Igor-lc/GDi_Tracker/V3.1.pdf

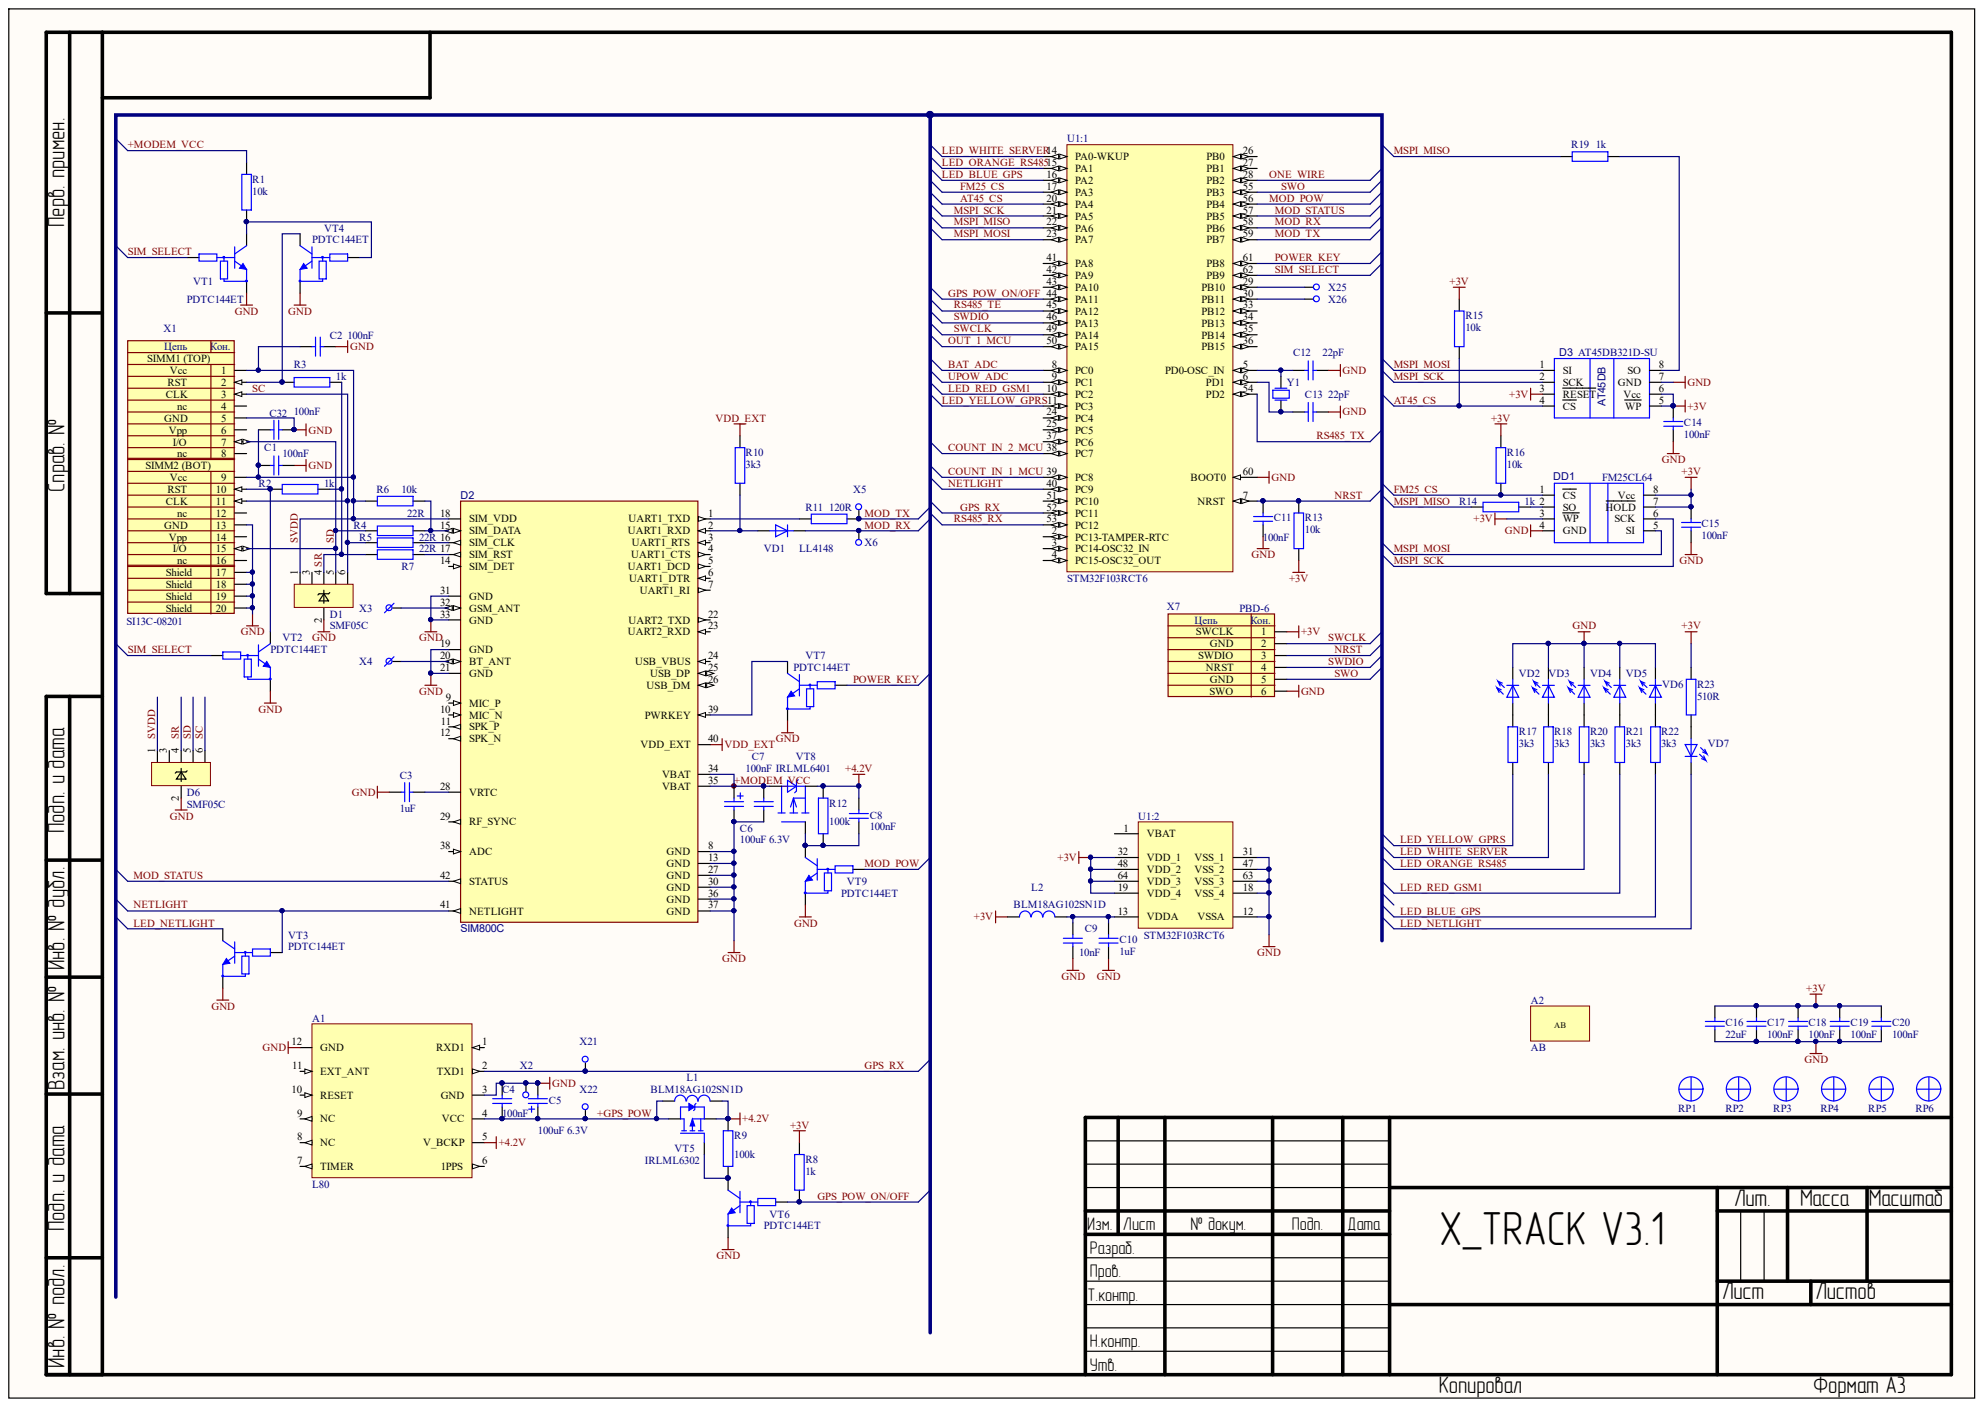
[picture p4: page 1]

Инв. № подл. Инв. № дубл. Подп. и дата Взам. инв. № Подп. и дата Перв. примен. Справ. №

V p p
I / O

Лит . | Масса | Масш таб

Изм . | Л и с т | № д о к у м . | По д п . | Д ата
Разр а б .
Пр о в .
Т . к о нтр . | | | | | Лист | Листов

Н . к о нтр .
Утв .

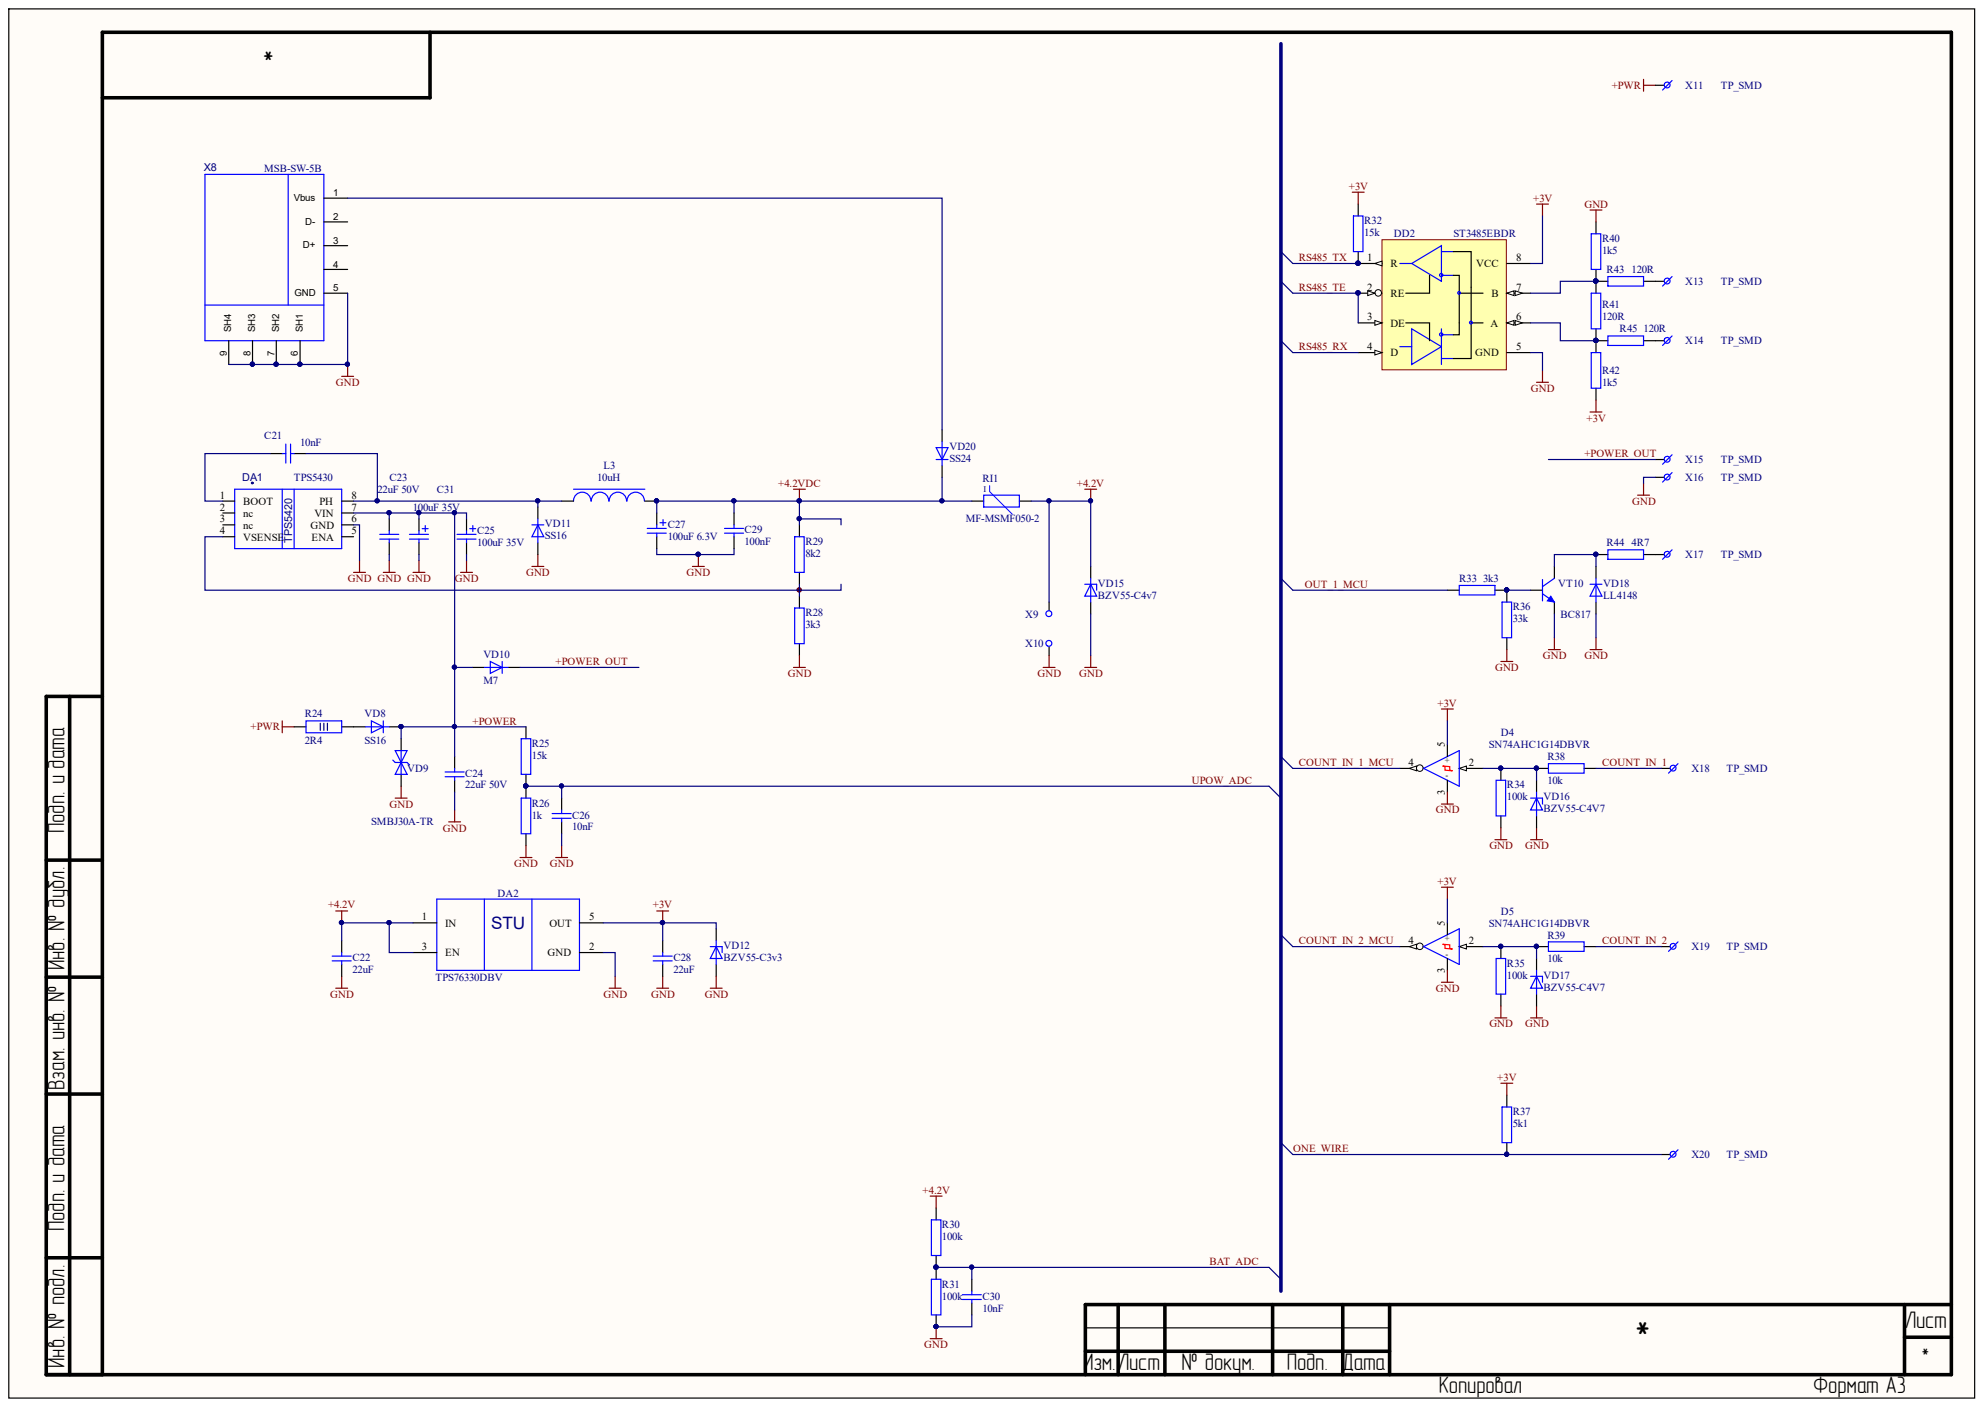
[picture p5: page 2]

* нв. № подл. Инв. № дубл. Подп. и дата Взам. инв. № Подп. и дата

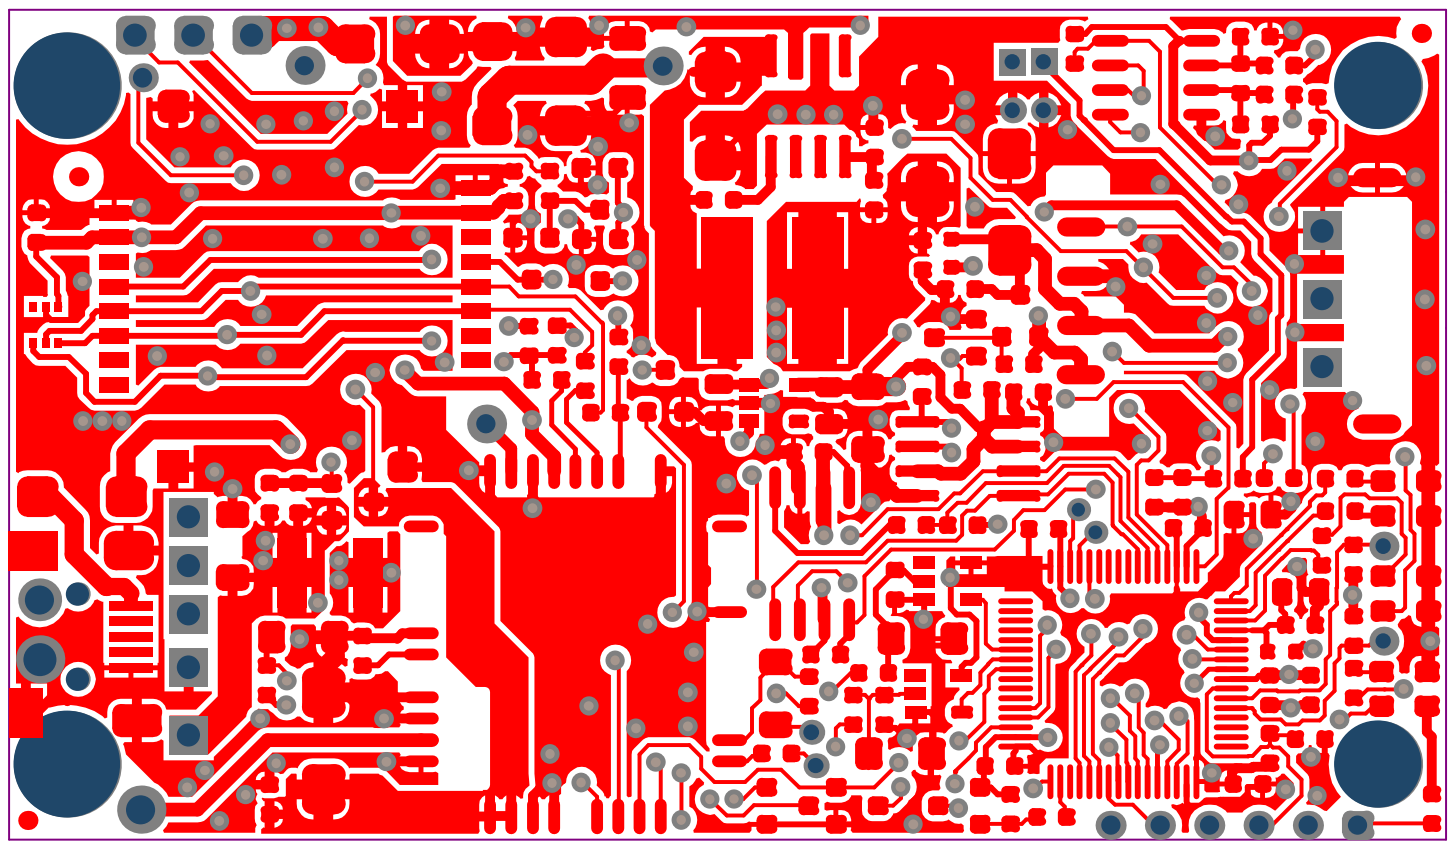
[picture p6: page 3]

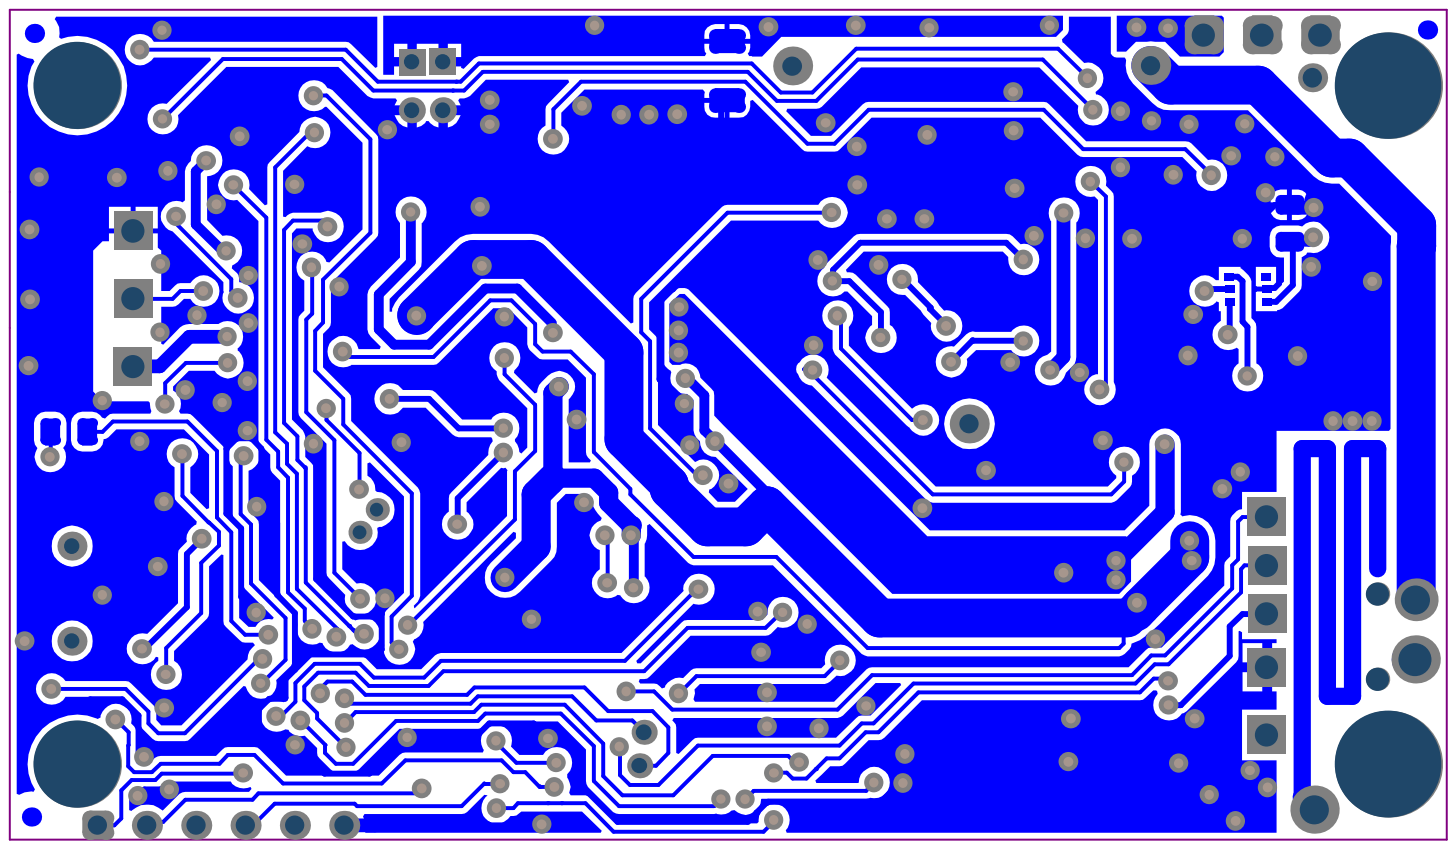
[picture p7: page 4]

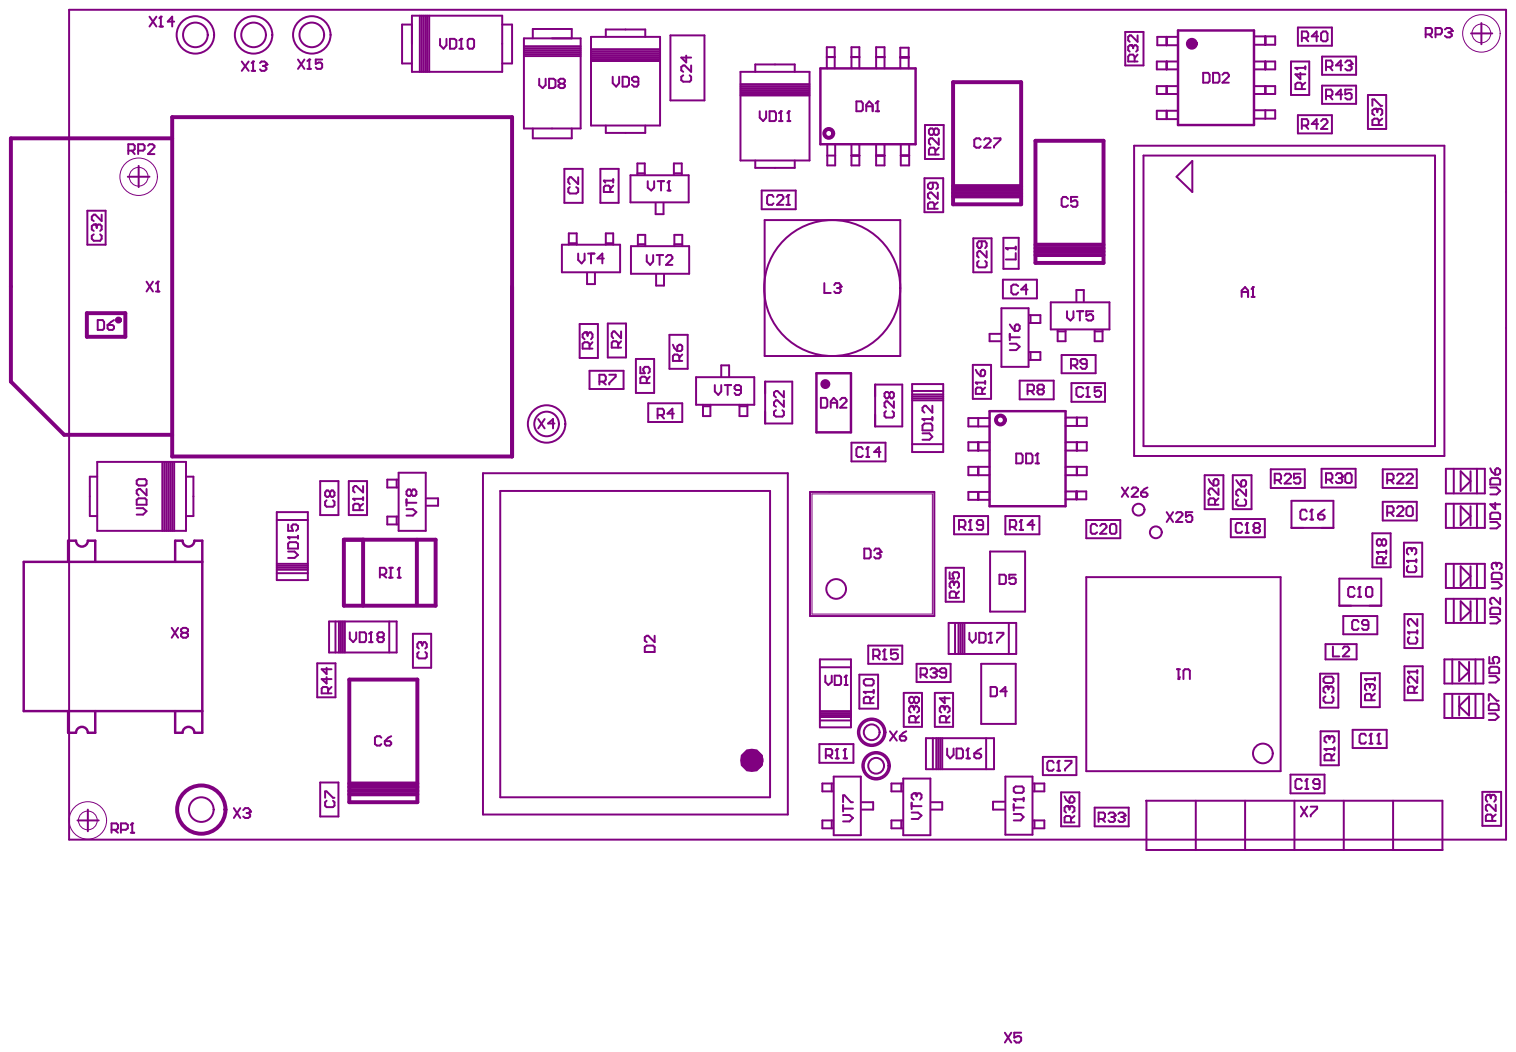
[picture p8: page 5]

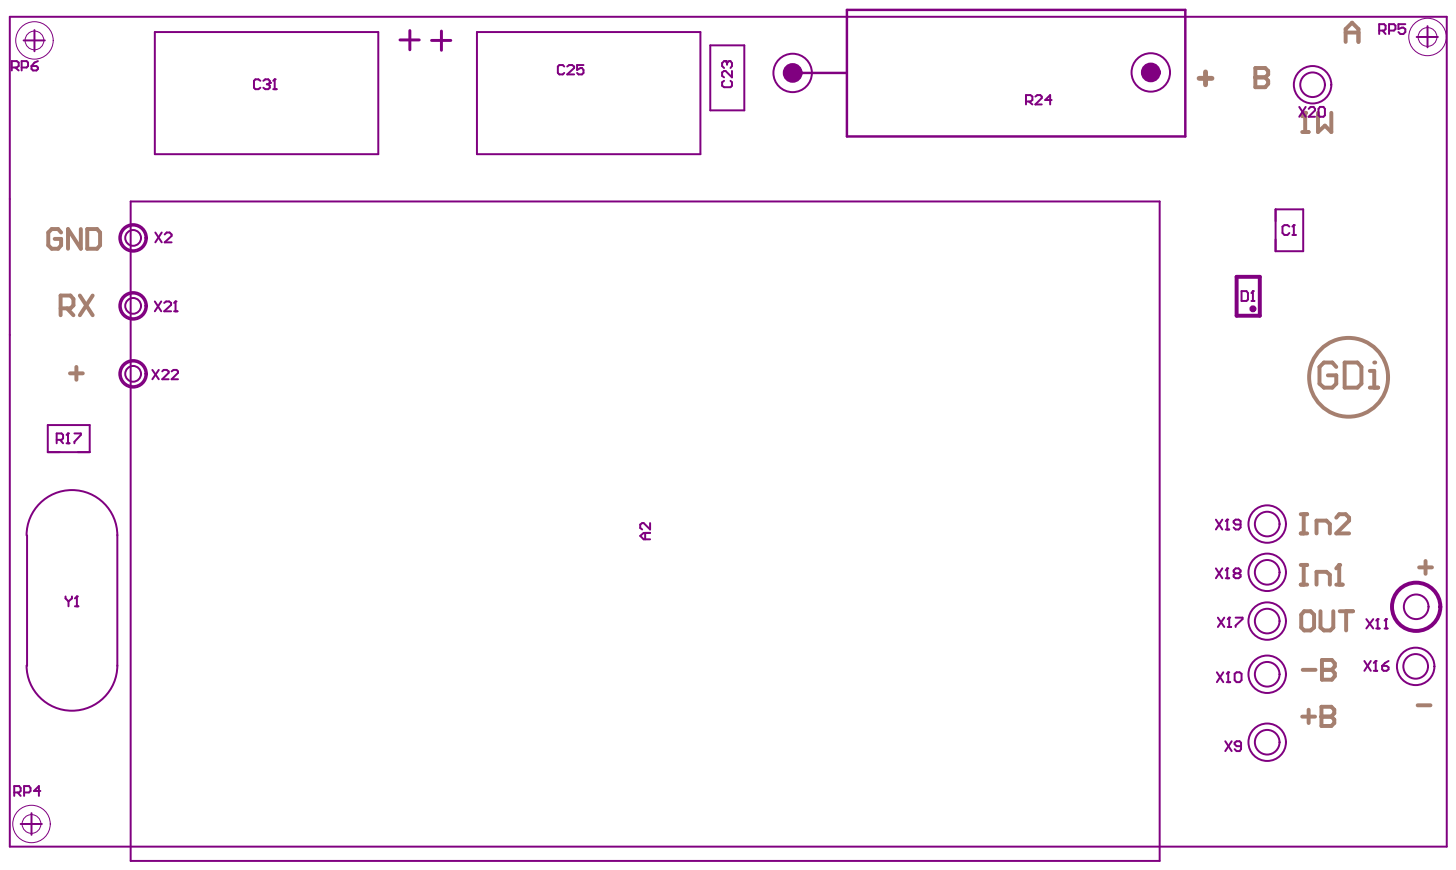
[picture p9: page 6]

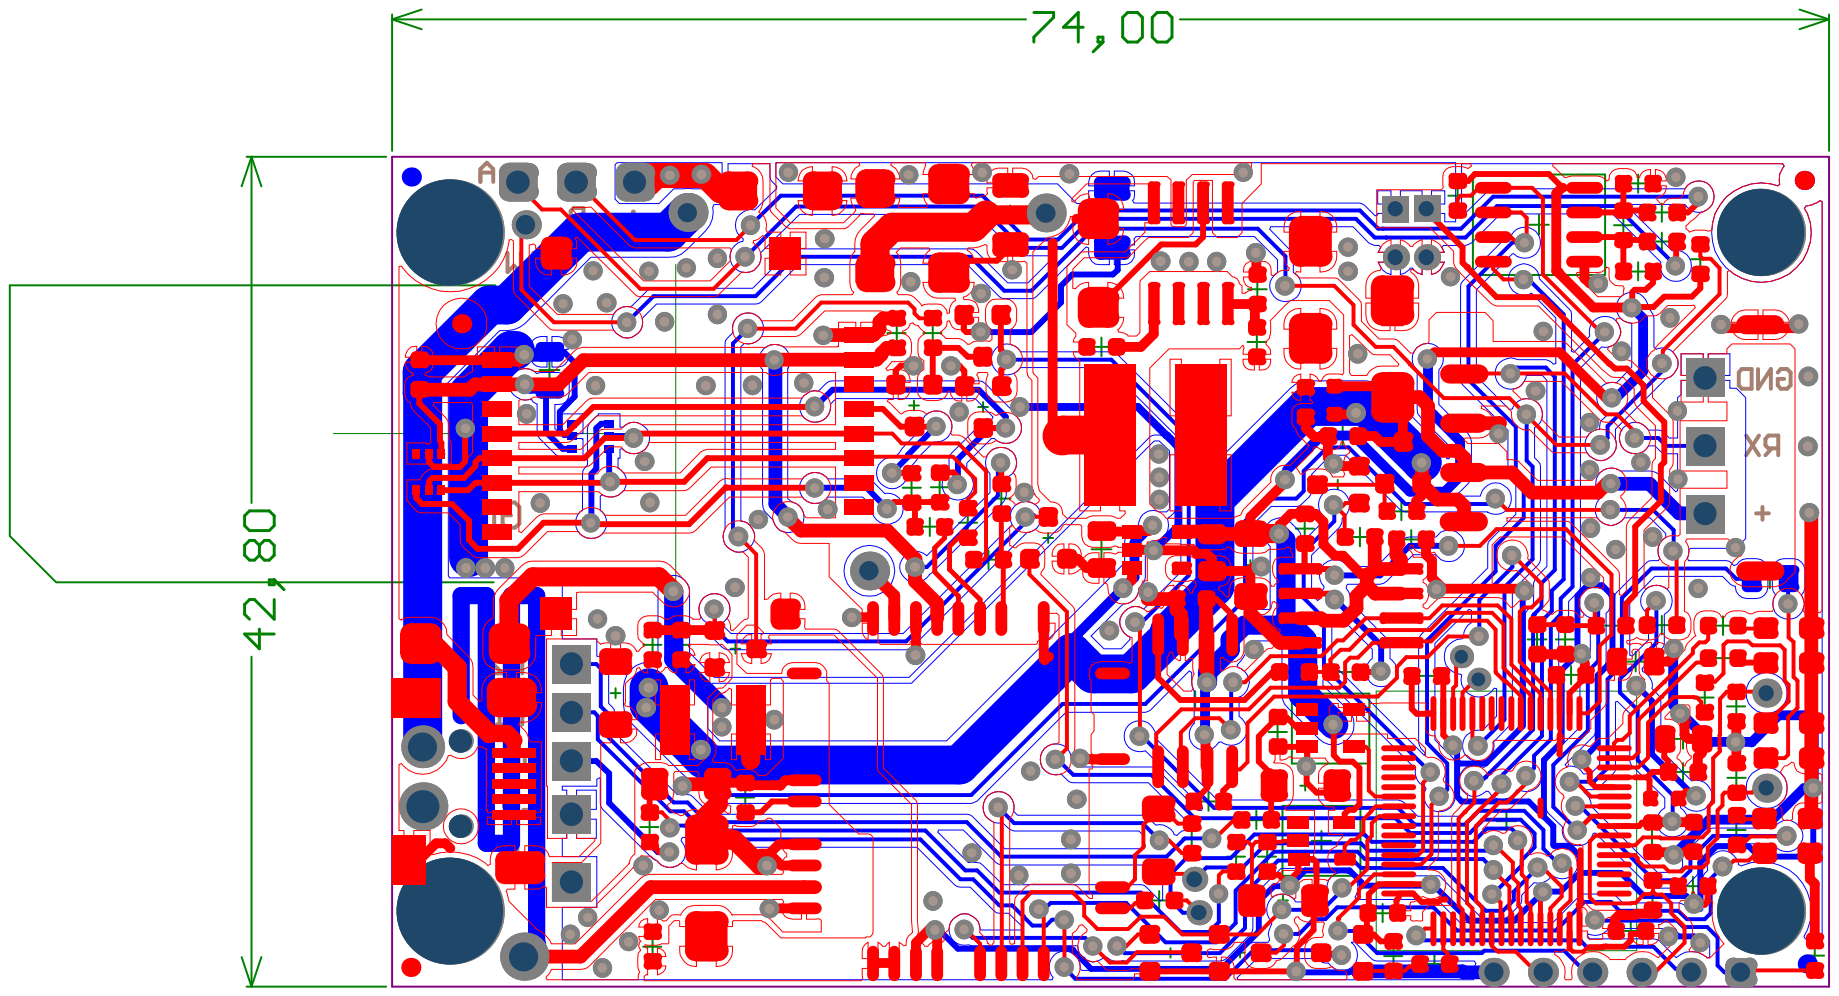
[picture p10: page 7]
