Igor-lc/GDi_Tracker/(list of files, drawings)

Other design files:
Altium_V3.1/X_TRACK V3.1.PcbDoc
Altium_V3.1/X_TRACK V3.1.PrjPcb
Altium_V3.1/X_TRACK_MCU V3.1.SchDoc
Altium_V3.1/X_TRACK_PWR V3.1.SchDoc
