Igor-lc/GDi_Tracker/GDi_Tracker_V3.1_69/modem/modem_sim900.c

#include "stm32f10x.h"
#include "stdint.h"
#include "stdio.h"
#include "modem_sim900.h"
#include "modem.h"
#include "modem_signals.h"
#include "ModemRingBuf.h"
#include "config.h"
#include "ByteStream.h"
#include "modem_parser.h"
#include "Disk.h"


	 
#ifdef DEBUG_SIM900	 
static void OutDebugSim900( char const *dbg_msg);
static void OutDebugSim900Sprintf( char const *str,uint32_t val);
#else
#define OutDebugSim900(x) __nop()
#define OutDebugSim900Sprintf(x,y) __nop()
#endif
static int modem_dma_busy_flag=0;
static MsmAnswerType answer_evt={MSM_ANSWER_SIG}; 
static QEvt const ParserWaitingIpSendEvt = { MODEM_PARSER_WAITING_IP_SEND_SIG, 0U, 0U};
static void Modem_hw_init (void);
static void ModemTxPin_init(void);
static void ModemRxPin_init(void);
static QState OkHandler(SIM900 *me);
static QState TickHandler(SIM900 *me);
static QState ErrorHandler(SIM900 *me,AnswerEnum answer);
static QState ModemSM_initial(SIM900 *me, QEvent const *e);
static QState ModemSM_idle(SIM900 *me, QEvent const *e);//1
static QState ModemSM_power_on(SIM900 *me, QEvent const *e);//2
static QState ModemSM_power_off(SIM900 *me, QEvent const *e);//3
static QState ModemSM_power_on_with_power_key(SIM900 *me, QEvent const *e);//4
static QState ModemSM_waiting_status_ok(SIM900 *me, QEvent const *e);//5
static QState ModemSM_send_at(SIM900 *me, QEvent const *e);//6
static QState ModemSM_fix_baudrate(SIM900 *me, QEvent const *e) ;//7
static QState ModemSM_check_baudrate(SIM900 *me, QEvent const *e) ;//8
static QState ModemSM_echo_off(SIM900 *me, QEvent const *e);//9
static QState ModemSM_sim_det_off(SIM900 *me, QEvent const *e);//10
static QState ModemSM_get_imei(SIM900 *me,QEvent const *e);//11
static QState ModemSM_get_imsi(SIM900 *me,QEvent const *e);//12
static QState ModemSM_waiting_call_ready(SIM900 *me,QEvent const *e);//13
static QState ModemSM_sms_set_text_mode(SIM900 *me,QEvent const *e);//14
static QState ModemSM_sms_set_ind_mode(SIM900 *me,QEvent const *e);//15
static QState ModemSM_sms_set_show_mode_1(SIM900 *me,QEvent const *e);//16
static QState ModemSM_pause(SIM900 *me, QEvent const *e); //17
static QState ModemSM_gsm_reg(SIM900 *me, QEvent const *e);//18
static QState ModemSM_open_gprs_check_ipstat(SIM900 *me,QEvent const *e);//19
static QState ModemSM_gprs_attach(SIM900 *me,QEvent const *e);//20
static QState ModemSM_add_iphead_mode(SIM900 *me,QEvent const *e);//21
static QState ModemSM_set_manual_getdata_mode(SIM900 *me,QEvent const *e);//22
static QState ModemSM_set_apn(SIM900 *me,QEvent const *e);//23
static QState ModemSM_start_task(SIM900 *me,QEvent const *e); //24
static QState ModemSM_bring_up_gprs_con(SIM900 *me,QEvent const *e);//25
static QState ModemSM_get_local_ip_address(SIM900 *me,QEvent const *e); //26
static QState ModemSM_packet_request_to_send(SIM900 *me,QEvent const *e);//27
static QState ModemSM_packet_send(SIM900 *me,QEvent const *e);//28
static QState ModemSM_waiting_tcp_data(SIM900 *me,QEvent const *e);//29 
static QState ModemSM_get_tcp_data(SIM900 *me,QEvent const *e);//30
static QState ModemSM_check_sim(SIM900 *me,QEvent const *e); //34
static QState ModemSM_set_te_character(SIM900 *me,QEvent const *e) ;//35
static QState ModemSM_aon_on(SIM900 *me,QEvent const *e) ;//36
static QState ModemSM_set_message_storage(SIM900 *me,QEvent const *e);
static QState ModemSM_waiting_sms_ready(SIM900 *me,QEvent const *e);
static QState ModemSM_waiting_gprs_ready(SIM900 *me,QEvent const *e) ;
//static QState ModemSM_get_ver(SIM900 *me,QEvent const *e) ;


//---------------------State Transition Tables ---------------------------------------
static StateType const power_on_start_up_stt[] = 
{  //handler,                                                     err, ok
   {(QStateHandler) & ModemSM_power_on,               ExitIfError, 0,  1},//ok
   {(QStateHandler) & ModemSM_power_on_with_power_key,ExitIfError, 0, 10},//ok
   {(QStateHandler) & ModemSM_waiting_status_ok,      ExitIfError, 20, 15},//ok
   {(QStateHandler) & ModemSM_send_at,                ExitIfError, 50, 0},//ok
   {(QStateHandler) & ModemSM_check_baudrate,         NextIfError, 20, 0},//ok
   {(QStateHandler) & ModemSM_fix_baudrate,           ExitIfError, 20, 0},//ok
   {(QStateHandler) & ModemSM_echo_off,               ExitIfError, 20, 0},//ok
   {(QStateHandler) & ModemSM_sim_det_off,            ExitIfError, 20, 0},//ok
   {(QStateHandler) & ModemSM_get_imei,               ExitIfError, 20, 0},//ok
	 //{(QStateHandler) & ModemSM_get_ver,                ExitIfError, 0, 10},//ok
   {(QStateHandler) & ModemSM_check_sim,              ExitIfError, 100, 0},//ok
   {(QStateHandler) & ModemSM_waiting_call_ready,     ExitIfError,300, 0},//ok
	 {(QStateHandler) & ModemSM_waiting_sms_ready,      ExitIfError,100, 0},//ok
   {(QStateHandler) & ModemSM_get_imsi,               ExitIfError, 20, 0},//ok
   {(QStateHandler) & ModemSM_set_te_character,       ExitIfError, 10, 0},//ok
   {(QStateHandler) & ModemSM_sms_set_text_mode,      ExitIfError, 10, 0},//ok
   {(QStateHandler) & ModemSM_sms_set_ind_mode,       ExitIfError, 10, 0},//ok
   {(QStateHandler) & ModemSM_set_message_storage,    ExitIfError, 10, 0},//ok
   {(QStateHandler) & ModemSM_aon_on,                 ExitIfError, 10, 0},
   {NULL,ExitIfError,0,0}  
};

static StateType const hard_reset_stt[] = 
{                                                                //err, ok
   {(QStateHandler) & ModemSM_power_off,              ExitIfError, 0,  20},
   {(QStateHandler) & ModemSM_pause,                  ExitIfError, 0, 200},
   {NULL,ExitIfError,0,0}  
};

static StateType const open_gsm_stt[] = 
{                                                               //err, ok
   {(QStateHandler) & ModemSM_gsm_reg,               ExitIfError, 600,  0},
   {NULL,ExitIfError,0,0}  
};

static StateType const open_gprs_stt[] = 
{                                                                     //err, ok
   {(QStateHandler) & ModemSM_open_gprs_check_ipstat,       ExitIfError, 50,  0},
   {(QStateHandler) & ModemSM_waiting_gprs_ready,           ExitIfError,100,  0},
	 {(QStateHandler) & ModemSM_gprs_attach,                  ExitIfError,300,  0},
   {(QStateHandler) & ModemSM_add_iphead_mode,              ExitIfError, 10,  0},
   {(QStateHandler) & ModemSM_set_manual_getdata_mode,      ExitIfError, 10,  0},
   {(QStateHandler) & ModemSM_set_apn,                      ExitIfError, 10,  0},
   {(QStateHandler) & ModemSM_start_task,                   ExitIfError, 10,  0},
   {(QStateHandler) & ModemSM_bring_up_gprs_con,            ExitIfError,600,  0},
   {(QStateHandler) & ModemSM_get_local_ip_address,         ExitIfError,100,  0},
   {NULL,ExitIfError,0,0}  
};


static StateType const send_packet_stt[] = 
{                                                                     //err, ok
   {(QStateHandler) & ModemSM_packet_request_to_send,       ExitIfError, 100,0},
   {(QStateHandler) & ModemSM_packet_send,                  ExitIfError, 100,0},
   {(QStateHandler) & ModemSM_waiting_tcp_data,             ExitIfError, 100,0},
   {(QStateHandler) & ModemSM_get_tcp_data,                 ExitIfError,  50,0},
   {NULL,                                                   ExitIfError,   0,0}  
};

static StateType const get_tcp_data_stt[] = 
{                                                                     //err, ok
	// {(QStateHandler) & ModemSM_waiting_tcp_data,             ExitIfError,  0,30},
   {(QStateHandler) & ModemSM_get_tcp_data,                 ExitIfError,  10,0},//1 sec err
   {NULL,                                                   ExitIfError,   0,0}  
};

//-------------------END OF STT------------------------------------------------------

void ModemSM_ctor(SIM900 *me) 
   {
   QFsm_ctor(&me->super, (QStateHandler)&ModemSM_initial);
   }

QState ModemSM_initial(SIM900 *me, QEvent const *e) 
   {
   (void)e;
   Modem_hw_init();
   QS_FUN_DICTIONARY(&ModemSM_initial);
   QS_FUN_DICTIONARY(&ModemSM_idle);
   QS_FUN_DICTIONARY(&ModemSM_power_on);
   QS_FUN_DICTIONARY(&ModemSM_power_on_with_power_key);
   QS_FUN_DICTIONARY(&ModemSM_waiting_status_ok);
   QS_FUN_DICTIONARY(&ModemSM_send_at);
   QS_FUN_DICTIONARY(&ModemSM_check_baudrate);
   QS_FUN_DICTIONARY(&ModemSM_fix_baudrate);
   QS_FUN_DICTIONARY(&ModemSM_echo_off);
   QS_FUN_DICTIONARY(&ModemSM_sim_det_off);
   QS_FUN_DICTIONARY(&ModemSM_get_imei);
   QS_FUN_DICTIONARY(&ModemSM_waiting_call_ready);
   QS_FUN_DICTIONARY(&ModemSM_get_imsi);
   QS_FUN_DICTIONARY(&ModemSM_sms_set_text_mode);
   QS_FUN_DICTIONARY(&ModemSM_sms_set_ind_mode);
   QS_FUN_DICTIONARY(&ModemSM_sms_set_show_mode_1);
   QS_FUN_DICTIONARY(&ModemSM_power_off);
   QS_FUN_DICTIONARY(&ModemSM_pause);
   QS_FUN_DICTIONARY(&ModemSM_gsm_reg);
   QS_FUN_DICTIONARY(&ModemSM_open_gprs_check_ipstat);
   QS_FUN_DICTIONARY(&ModemSM_gprs_attach);
   QS_FUN_DICTIONARY(&ModemSM_add_iphead_mode);
   QS_FUN_DICTIONARY(&ModemSM_set_manual_getdata_mode);
   QS_FUN_DICTIONARY(&ModemSM_set_apn);
   QS_FUN_DICTIONARY(&ModemSM_start_task);
   QS_FUN_DICTIONARY(&ModemSM_bring_up_gprs_con);
   QS_FUN_DICTIONARY(&ModemSM_get_local_ip_address);
   QS_FUN_DICTIONARY(&ModemSM_packet_request_to_send);
   QS_FUN_DICTIONARY(&ModemSM_packet_send);
   QS_FUN_DICTIONARY(&ModemSM_waiting_tcp_data);
   QS_FUN_DICTIONARY(&ModemSM_get_tcp_data);
	 QS_FUN_DICTIONARY(&ModemSM_check_sim);
	 QS_FUN_DICTIONARY(&ModemSM_set_te_character);
	 QS_FUN_DICTIONARY(&ModemSM_aon_on);

   QS_SIG_DICTIONARY(TIC_100ms_SIG, me);
   return Q_TRAN(&ModemSM_idle);
   }



QState ModemSM_idle(SIM900 *me, QEvent const *e) 
   {
   switch (e->sig)
      {
      case Q_ENTRY_SIG: return Q_HANDLED();
      case Q_EXIT_SIG:  return Q_HANDLED();
      case MSM_POWER_ON_START_UP_SIG:
         {
            me->sst_ptr=power_on_start_up_stt;
            return Q_TRAN(*me->sst_ptr->handler);
         }   
      case MSM_HARD_RESET_SIG:
         {
            me->sst_ptr=hard_reset_stt;
            return Q_TRAN(*me->sst_ptr->handler);
         }
      case MSM_OPEN_GSM_SIG:
         {
            me->sst_ptr=open_gsm_stt;
            return Q_TRAN(*me->sst_ptr->handler);
         }
      case MSM_OPEN_GPRS_SIG:
         {
            me->sst_ptr=open_gprs_stt;
            return Q_TRAN(*me->sst_ptr->handler);
         }
			case MSM_SEND_PACKET_SIG:
				 {
					  me->sst_ptr=send_packet_stt;
            return Q_TRAN(*me->sst_ptr->handler);
				 }
			case MSM_GET_TCP_DATA_SIG:
				 {
					  me->sst_ptr=get_tcp_data_stt;
            return Q_TRAN(*me->sst_ptr->handler);
				 }
      }
   return Q_IGNORED();
   }

QState ModemSM_power_on(SIM900 *me, QEvent const *e) 
   {
   switch (e->sig)
      {
      case Q_ENTRY_SIG:
         {
            me->flag.call_ready=0;
					 // SelectSim(me);
            POWERKEY_UP(); 						
            MODEM_POWER_ON(); 
            ModemTxPin_init();
            ModemRxPin_init();      
            me->tick_100ms_counter=0;
         }
         return Q_HANDLED(); 
      case MODEM_SIM_PIN_SIG:
      case MODEM_SIM_PUK_SIG:
      case MODEM_PH_SIM_PIN_SIG:
      case MODEM_PH_SIM_PUK_SIG:
      case MODEM_SIM_PIN2_SIG:
      case MODEM_SIM_PUK2_SIG: return ErrorHandler(me,ANSWER_SIM_LOCK);
      case MODEM_SIM_NOT_READY_SIG:
      case MODEM_SIM_NOT_INSERTED_SIG: return ErrorHandler(me,ANSWER_SIM_ERROR);
      case TIC_100ms_SIG: return TickHandler(me); 
      case Q_EXIT_SIG: return Q_HANDLED();          
      }
   return Q_IGNORED();
   }

QState ModemSM_power_off(SIM900 *me, QEvent const *e) 
   {
   switch (e->sig)
      {
      case Q_ENTRY_SIG:
         {
            ModemTxPin_deinit();
            ModemRxPin_deinit();
            POWERKEY_DOWN();
            MODEM_POWER_OFF();
            me->tick_100ms_counter=0;
            SysInfo.gsmq=0;
         }
         return Q_HANDLED(); 
      case TIC_100ms_SIG: return TickHandler(me);
      case MODEM_SIM_NOT_READY_SIG:
      case MODEM_SIM_NOT_INSERTED_SIG: return ErrorHandler(me,ANSWER_SIM_ERROR);         
      case Q_EXIT_SIG: return Q_HANDLED();         
      }
   return Q_IGNORED();
   }

QState ModemSM_pause(SIM900 *me, QEvent const *e) 
   {
   switch (e->sig)
      {
      case Q_ENTRY_SIG:
         {
            me->tick_100ms_counter=0;
         }
         return Q_HANDLED(); 
      case TIC_100ms_SIG: return TickHandler(me); 
      case MODEM_SIM_NOT_READY_SIG:
      case MODEM_SIM_NOT_INSERTED_SIG: return ErrorHandler(me,ANSWER_SIM_ERROR);
      case Q_EXIT_SIG: return Q_HANDLED();         
      }
   return Q_IGNORED();
   }



QState ModemSM_power_on_with_power_key(SIM900 *me, QEvent const *e) 
   {
   QState ret=Q_HANDLED();
   switch (e->sig)
      {
      case Q_ENTRY_SIG:
         { 
            POWERKEY_DOWN();   
            me->tick_100ms_counter=0;
         }
         return ret;
      case TIC_100ms_SIG: return TickHandler(me); 
      case MODEM_SIM_PIN_SIG:
      case MODEM_SIM_PUK_SIG:
      case MODEM_PH_SIM_PIN_SIG:
      case MODEM_PH_SIM_PUK_SIG:
      case MODEM_SIM_PIN2_SIG:
      case MODEM_SIM_PUK2_SIG: return ErrorHandler(me,ANSWER_SIM_LOCK);
      case MODEM_SIM_NOT_READY_SIG:
      case MODEM_SIM_NOT_INSERTED_SIG: return ErrorHandler(me,ANSWER_SIM_ERROR);
      case Q_EXIT_SIG:
         {
            POWERKEY_UP(); 
					 __nop();
         }
         return ret;
      }
   return Q_IGNORED();
   }

QState ModemSM_waiting_status_ok(SIM900 *me, QEvent const *e) 
   {
   QState ret=Q_HANDLED();
   switch (e->sig)
      {
      case Q_ENTRY_SIG:
         {   
            me->tick_100ms_counter=0;
         }
         return ret; 
      case TIC_100ms_SIG: 
			{
				if(GET_MODEM_STATUS())
				{
					return OkHandler(me);
				}
			}
				return TickHandler(me);
      case MODEM_SIM_PIN_SIG:
      case MODEM_SIM_PUK_SIG:
      case MODEM_PH_SIM_PIN_SIG:
      case MODEM_PH_SIM_PUK_SIG:
      case MODEM_SIM_PIN2_SIG:
      case MODEM_SIM_PUK2_SIG: return ErrorHandler(me,ANSWER_SIM_LOCK);
      case MODEM_SIM_NOT_READY_SIG:
      case MODEM_SIM_NOT_INSERTED_SIG: return ErrorHandler(me,ANSWER_SIM_ERROR);        
      case Q_EXIT_SIG: return Q_HANDLED();
      }
   return Q_IGNORED();
   }

QState ModemSM_send_at(SIM900 *me, QEvent const *e) 
   {
   QState ret=Q_HANDLED();
   switch (e->sig)
      {
      case Q_ENTRY_SIG:
         {   
            ModemSendCommand("AT\r\n");
            me->tick_100ms_counter=0;
            me->counter=0;
         }
         return ret; 
      case TIC_100ms_SIG:
         {         
            ret= TickHandler(me); 
            if ((ret==Q_HANDLED())&&(++me->counter==10))
               {
               me->counter=0;
               ModemSendCommand("AT\r\n");
               }
         }
         return ret;
      case MODEM_OK_SIG: return OkHandler(me);
      case MODEM_SIM_PIN_SIG:
      case MODEM_SIM_PUK_SIG:
      case MODEM_PH_SIM_PIN_SIG:
      case MODEM_PH_SIM_PUK_SIG:
      case MODEM_SIM_PIN2_SIG:
      case MODEM_SIM_PUK2_SIG: return ErrorHandler(me,ANSWER_SIM_LOCK);
      case MODEM_SIM_NOT_READY_SIG:
      case MODEM_SIM_NOT_INSERTED_SIG: return ErrorHandler(me,ANSWER_SIM_ERROR);      
      case Q_EXIT_SIG: return Q_HANDLED();
      }
   return Q_IGNORED();
   }

QState ModemSM_check_baudrate(SIM900 *me, QEvent const *e) 
   {
   QState ret=Q_HANDLED();
   switch (e->sig)
      {
      case Q_ENTRY_SIG:
         {   
            ModemSendCommand("AT+IPR?\r\n");
            me->tick_100ms_counter=0;
            me->counter=0;
            me->flag.next_ok=0;
         }
         return ret; 
      case TIC_100ms_SIG:
         {         
            ret= TickHandler(me); 
            if ((ret==Q_HANDLED())&&(++me->counter==5))
               {
               me->counter=0;
               ModemSendCommand("AT+IPR?\r\n");
               }
         }
         return ret;
      case MODEM_BAUDRATE_115200_SIG:
         {
            me->flag.next_ok=1;
         }
         return ret;
      case MODEM_OK_SIG:
         {
            if (me->flag.next_ok==1)ret=OkHandler(me);
         }
         return ret;
       case MODEM_SIM_PIN_SIG:
      case MODEM_SIM_PUK_SIG:
      case MODEM_PH_SIM_PIN_SIG:
      case MODEM_PH_SIM_PUK_SIG:
      case MODEM_SIM_PIN2_SIG:
      case MODEM_SIM_PUK2_SIG: return ErrorHandler(me,ANSWER_SIM_LOCK);
      case MODEM_SIM_NOT_READY_SIG:
      case MODEM_SIM_NOT_INSERTED_SIG: return ErrorHandler(me,ANSWER_SIM_ERROR);
      case Q_EXIT_SIG: return Q_HANDLED();
      }
   return Q_IGNORED();
   }

QState ModemSM_fix_baudrate(SIM900 *me, QEvent const *e) 
   {
   QState ret=Q_HANDLED();
   switch (e->sig)
      {
      case Q_ENTRY_SIG:
         {   
            ModemSendCommand("AT+IPR=115200\r\n");
            me->tick_100ms_counter=0;
            me->counter=0;
         }
         return ret; 
      case TIC_100ms_SIG:
         {         
            ret= TickHandler(me); 
            if ((ret==Q_HANDLED())&&(++me->counter==5))
               {
               me->counter=0;
               ModemSendCommand("AT+IPR=115200\r\n");
               }
         }
         return ret;
      case MODEM_OK_SIG: return OkHandler(me);
      case MODEM_SIM_PIN_SIG:
      case MODEM_SIM_PUK_SIG:
      case MODEM_PH_SIM_PIN_SIG:
      case MODEM_PH_SIM_PUK_SIG:
      case MODEM_SIM_PIN2_SIG:
      case MODEM_SIM_PUK2_SIG: return ErrorHandler(me,ANSWER_SIM_LOCK);
      case MODEM_SIM_NOT_READY_SIG:
      case MODEM_SIM_NOT_INSERTED_SIG: return ErrorHandler(me,ANSWER_SIM_ERROR);      
      case Q_EXIT_SIG: return Q_HANDLED();
      }
   return Q_IGNORED();
   }


QState ModemSM_echo_off(SIM900 *me, QEvent const *e) 
   {
   QState ret=Q_HANDLED();
   switch (e->sig)
      {
      case Q_ENTRY_SIG:
         {   
            me->done=ModemSendCommand("ATE0\r\n");
            me->tick_100ms_counter=0;
         }
         return ret; 
      case TIC_100ms_SIG:
         {         
            if ((ret=TickHandler(me))==Q_HANDLED()&&me->done==0)
               {
               me->done=ModemSendCommand("ATE0\r\n");
               }
         }
         return ret;
      case MODEM_OK_SIG: return OkHandler(me);
      case MODEM_SIM_PIN_SIG:
      case MODEM_SIM_PUK_SIG:
      case MODEM_PH_SIM_PIN_SIG:
      case MODEM_PH_SIM_PUK_SIG:
      case MODEM_SIM_PIN2_SIG:
      case MODEM_SIM_PUK2_SIG: return ErrorHandler(me,ANSWER_SIM_LOCK);
      case MODEM_SIM_NOT_READY_SIG:
      case MODEM_SIM_NOT_INSERTED_SIG: return ErrorHandler(me,ANSWER_SIM_ERROR);   
      case Q_EXIT_SIG: return Q_HANDLED();
      }
   return Q_IGNORED();
   }


QState ModemSM_sim_det_off(SIM900 *me, QEvent const *e) 
   {
   QState ret=Q_HANDLED();
   switch (e->sig)
      {
      case Q_ENTRY_SIG:
         {   
            me->done= ModemSendCommand("AT+CSDT?\r\n");
            me->tick_100ms_counter=0;
         }
         return ret; 
      case TIC_100ms_SIG:
         {         
            if ((ret=TickHandler(me))==Q_HANDLED()&&me->done==0)
               {
               me->done= ModemSendCommand("AT+CSDT?\r\n");
               }
         }
         return ret;
      case MODEM_OK_SIG: return OkHandler(me); 
      case MODEM_ERROR_SIG: return ErrorHandler(me,ANSWER_ERROR);
      case MODEM_SIM_PIN_SIG:
      case MODEM_SIM_PUK_SIG:
      case MODEM_PH_SIM_PIN_SIG:
      case MODEM_PH_SIM_PUK_SIG:
      case MODEM_SIM_PIN2_SIG:
      case MODEM_SIM_PUK2_SIG: return ErrorHandler(me,ANSWER_SIM_LOCK);
      case MODEM_SIM_NOT_READY_SIG:
      case MODEM_SIM_NOT_INSERTED_SIG: return ErrorHandler(me,ANSWER_SIM_ERROR);
      case Q_EXIT_SIG: return Q_HANDLED();
      }
   return Q_IGNORED();
   }


QState ModemSM_get_imei(SIM900 *me,QEvent const *e) 
   {
   QState ret=Q_HANDLED();
   switch (e->sig)
      {
      case Q_ENTRY_SIG:
         {   
            me->done=ModemSendCommand("AT+GSN\r\n"); 
            me->tick_100ms_counter=0;
            me->counter=0;
            me->flag.next_ok=0;
         }
         return ret; 
      case TIC_100ms_SIG:
         {         
            if ((ret=TickHandler(me))==Q_HANDLED()&&me->done==0)
               {
               me->done=ModemSendCommand("AT+GSN\r\n"); 
               }
         }
         return ret;
      case MODEM_IMEI_IMSI_SIG:
         {
          //  memcpy(me->imei,((ParserImeiImsiMessageType*)e)->ptr,16);
					  DataPtrEvt *pe =(DataPtrEvt*)e;
					   memcpy(me->imei,pe->ptr,16);
            char print_buf[25];
            sprintf(print_buf,"IMEI=%s",me->imei);
            OutDebugSim900(print_buf);            
            me->flag.next_ok=1;
         }
         return ret;
      case MODEM_OK_SIG:
         {
            if (me->flag.next_ok==1)ret=OkHandler(me);
         }
         return ret;
      case MODEM_ERROR_SIG: return ErrorHandler(me,ANSWER_ERROR);
      case MODEM_SIM_PIN_SIG:
      case MODEM_SIM_PUK_SIG:
      case MODEM_PH_SIM_PIN_SIG:
      case MODEM_PH_SIM_PUK_SIG:
      case MODEM_SIM_PIN2_SIG:
      case MODEM_SIM_PUK2_SIG: return ErrorHandler(me,ANSWER_SIM_LOCK);
      case MODEM_SIM_NOT_READY_SIG:
      case MODEM_SIM_NOT_INSERTED_SIG: return ErrorHandler(me,ANSWER_SIM_ERROR);
      case Q_EXIT_SIG: return Q_HANDLED();
      }
   return Q_IGNORED();
   }
	 
	 /*QState ModemSM_get_ver(SIM900 *me,QEvent const *e) 
   {
   QState ret=Q_HANDLED();
   switch (e->sig)
      {
      case Q_ENTRY_SIG:
         {   
            me->done=ModemSendCommand("AT+GMR\r\n"); 
            me->tick_100ms_counter=0;
         }
         return ret; 
				 
			case TIC_100ms_SIG: return TickHandler(me); 
     
      case MODEM_ERROR_SIG: return ErrorHandler(me,ANSWER_ERROR);
      case MODEM_SIM_PIN_SIG:
      case MODEM_SIM_PUK_SIG:
      case MODEM_PH_SIM_PIN_SIG:
      case MODEM_PH_SIM_PUK_SIG:
      case MODEM_SIM_PIN2_SIG:
      case MODEM_SIM_PUK2_SIG: return ErrorHandler(me,ANSWER_SIM_LOCK);
      case MODEM_SIM_NOT_READY_SIG:
      case MODEM_SIM_NOT_INSERTED_SIG: return ErrorHandler(me,ANSWER_SIM_ERROR);
      case Q_EXIT_SIG: return Q_HANDLED();
      }
   return Q_IGNORED();
   }
*/


QState ModemSM_waiting_call_ready(SIM900 *me,QEvent const *e) 
   {
   QState ret=Q_HANDLED();
   switch (e->sig)
      {
      case Q_ENTRY_SIG:
         {   
            me->tick_100ms_counter=0;
         }
         return ret; 
      case TIC_100ms_SIG: return TickHandler(me); 
      case MODEM_CALL_READY_SIG: return OkHandler(me);
      case MODEM_SIM_PIN_SIG:
      case MODEM_SIM_PUK_SIG:
      case MODEM_PH_SIM_PIN_SIG:
      case MODEM_PH_SIM_PUK_SIG:
      case MODEM_SIM_PIN2_SIG:
      case MODEM_SIM_PUK2_SIG: return ErrorHandler(me,ANSWER_SIM_LOCK);
      case MODEM_SIM_NOT_READY_SIG:
      case MODEM_SIM_NOT_INSERTED_SIG: return ErrorHandler(me,ANSWER_SIM_ERROR);
      case Q_EXIT_SIG: return Q_HANDLED();
      }
   return Q_IGNORED();
   }
	 
	 QState ModemSM_waiting_sms_ready(SIM900 *me,QEvent const *e) 
   {
   QState ret=Q_HANDLED();
   switch (e->sig)
      {
      case Q_ENTRY_SIG:
         {   
            me->tick_100ms_counter=0;
         }
         return ret; 
      case TIC_100ms_SIG: return TickHandler(me); 
      case MODEM_SMS_READY_SIG: return OkHandler(me);
      case MODEM_SIM_PIN_SIG:
      case MODEM_SIM_PUK_SIG:
      case MODEM_PH_SIM_PIN_SIG:
      case MODEM_PH_SIM_PUK_SIG:
      case MODEM_SIM_PIN2_SIG:
      case MODEM_SIM_PUK2_SIG: return ErrorHandler(me,ANSWER_SIM_LOCK);
      case MODEM_SIM_NOT_READY_SIG:
      case MODEM_SIM_NOT_INSERTED_SIG: return ErrorHandler(me,ANSWER_SIM_ERROR);
      case Q_EXIT_SIG: return Q_HANDLED();
      }
   return Q_IGNORED();
   }


QState ModemSM_get_imsi(SIM900 *me,QEvent const *e) 
   {
   QState ret=Q_HANDLED();
   switch (e->sig)
      {
      case Q_ENTRY_SIG:
         {   
            me->done= ModemSendCommand("AT+CIMI\r\n");
            me->tick_100ms_counter=0;
            me->counter=0;
            me->flag.next_ok=0;
         }
         return ret; 
      case TIC_100ms_SIG:
         {
            if ((ret=TickHandler(me))==Q_HANDLED()&&me->done==0)
               {
               me->done= ModemSendCommand("AT+CIMI\r\n");
               }
         }
         return ret;
      case MODEM_IMEI_IMSI_SIG:
         {
           // memcpy(me->imsi,((ParserImeiImsiMessageType*)e)->ptr,16);
					  DataPtrEvt *pe =(DataPtrEvt*)e;
					  memcpy(me->imsi,pe->ptr,19);
            char print_buf[30];
            sprintf(print_buf,"IMSI=%s",me->imsi);
            OutDebugSim900(print_buf);            
            me->flag.next_ok=1;
         }
         return ret;
      case MODEM_OK_SIG:
         {
            if (me->flag.next_ok==1)ret=OkHandler(me);
         }
         return ret;
      case MODEM_ERROR_SIG: return ErrorHandler(me,ANSWER_ERROR);
      case MODEM_SIM_PIN_SIG:
      case MODEM_SIM_PUK_SIG:
      case MODEM_PH_SIM_PIN_SIG:
      case MODEM_PH_SIM_PUK_SIG:
      case MODEM_SIM_PIN2_SIG:
      case MODEM_SIM_PUK2_SIG: return ErrorHandler(me,ANSWER_SIM_LOCK);
      case MODEM_SIM_NOT_READY_SIG:
      case MODEM_SIM_NOT_INSERTED_SIG: return ErrorHandler(me,ANSWER_SIM_ERROR);
      case Q_EXIT_SIG: return Q_HANDLED();
      }
   return Q_IGNORED();
   }
	 
	 QState ModemSM_check_sim(SIM900 *me,QEvent const *e) 
   {
   QState ret=Q_HANDLED();
		static AnswerEnum answer=ANSWER_ERROR;
   switch (e->sig)
      {
      case Q_ENTRY_SIG:
         {   
            me->done= ModemSendCommand("AT+CPIN?\r\n");
            me->tick_100ms_counter=0;
            me->counter=0;
            me->flag.next_ok=0;
					  me->flag.exit_error=0;
         }
         return ret; 
      case TIC_100ms_SIG:
         {
					 ret=TickHandler(me);
            //if ((ret=TickHandler(me))==Q_HANDLED()&&me->done==0)
					 if (ret==Q_HANDLED())
               {
                ModemSendCommand("AT+CPIN?\r\n");
               }
         }
         return ret;
      case MODEM_SIM_READY_SIG:
         {    
            OutDebugSim900("MODEM_SIM_READY_SIG");					 
            me->flag.next_ok=1;
         }
         return ret;
			 case MODEM_SIM_PIN2_SIG:
			 case MODEM_SIM_PUK2_SIG:
			 case MODEM_PH_SIM_PUK_SIG:
			 case MODEM_PH_SIM_PIN_SIG:
			 case MODEM_SIM_PIN_SIG:
			 case MODEM_SIM_PUK_SIG:
					  {  
							 OutDebugSim900("ANSWER_SIM_LOCK");	
               answer=ANSWER_SIM_LOCK;							
               me->flag.exit_error=1;
           }
           return ret;
      case MODEM_OK_SIG:
         {
            if (me->flag.next_ok==1)
						{
							ret=OkHandler(me);
						}
					  else if (me->flag.exit_error==1)
						{
							ret= ErrorHandler(me,answer);
						}
         }
         return ret;
      case MODEM_ERROR_SIG: 
			{
				OutDebugSim900("ERROR_SIG");
			}
				return ErrorHandler(me,ANSWER_ERROR);
      case MODEM_SIM_NOT_READY_SIG: 
			{
				OutDebugSim900("SIM_NOT_READY_SIG");
			}
        return ErrorHandler(me,ANSWER_SIM_ERROR);				 
      case MODEM_SIM_NOT_INSERTED_SIG: 
					{
				OutDebugSim900("MODEM_SIM_NOT_INSERTED_SIG");
			    }
				return ErrorHandler(me,ANSWER_SIM_ERROR);
      case Q_EXIT_SIG: return Q_HANDLED();
      }
   return Q_IGNORED();
   }




QState ModemSM_sms_set_text_mode(SIM900 *me,QEvent const *e) 
   {
   QState ret=Q_HANDLED();
   switch (e->sig)
      {
      case Q_ENTRY_SIG:
         {   
            me->done=ModemSendCommand("AT+CMGF=1\r\n");
            me->tick_100ms_counter=0;
            me->counter=0;
         }
         return ret; 
      case TIC_100ms_SIG:
         {
            if ((ret=TickHandler(me))==Q_HANDLED()&&me->done==0)
               {
               me->done=ModemSendCommand("AT+CMGF=1\r\n");
               }
         }
         return ret;
      case MODEM_OK_SIG: return OkHandler(me); 
      case MODEM_ERROR_SIG: return ErrorHandler(me,ANSWER_ERROR);
     case MODEM_SIM_PIN_SIG:
      case MODEM_SIM_PUK_SIG:
      case MODEM_PH_SIM_PIN_SIG:
      case MODEM_PH_SIM_PUK_SIG:
      case MODEM_SIM_PIN2_SIG:
      case MODEM_SIM_PUK2_SIG: return ErrorHandler(me,ANSWER_SIM_LOCK);
      case MODEM_SIM_NOT_READY_SIG:
      case MODEM_SIM_NOT_INSERTED_SIG: return ErrorHandler(me,ANSWER_SIM_ERROR);
      case Q_EXIT_SIG: return Q_HANDLED();
      }
   return Q_IGNORED();
   }


QState ModemSM_sms_set_ind_mode(SIM900 *me,QEvent const *e) 
   {
   QState ret=Q_HANDLED();
   switch (e->sig)
      {
      case Q_ENTRY_SIG:
         {   
					 
					  // me->done=ModemSendCommand( "AT+CNMI=1,2,2,1,0\r\n");
            me->done=ModemSendCommand("AT+CNMI=2,1\r\n");
            me->tick_100ms_counter=0;
            me->counter=0;
         }
         return ret; 
      case TIC_100ms_SIG:
         {
            if ((ret=TickHandler(me))==Q_HANDLED()&&me->done==0)
               {
								  //me->done=ModemSendCommand( "AT+CNMI=1,2,2,1,0\r\n");
               me->done=ModemSendCommand("AT+CNMI=2,1\r\n");
               }
         }
         return ret;
      case MODEM_OK_SIG: return OkHandler(me); 
      case MODEM_ERROR_SIG: return ErrorHandler(me,ANSWER_ERROR);
      case MODEM_SIM_PIN_SIG:
      case MODEM_SIM_PUK_SIG:
      case MODEM_PH_SIM_PIN_SIG:
      case MODEM_PH_SIM_PUK_SIG:
      case MODEM_SIM_PIN2_SIG:
      case MODEM_SIM_PUK2_SIG: return ErrorHandler(me,ANSWER_SIM_LOCK);
      case MODEM_SIM_NOT_READY_SIG:
      case MODEM_SIM_NOT_INSERTED_SIG: return ErrorHandler(me,ANSWER_SIM_ERROR);
      case Q_EXIT_SIG: return Q_HANDLED();
      }
   return Q_IGNORED();
   }


QState ModemSM_sms_set_show_mode_1(SIM900 *me,QEvent const *e) 
   {
   QState ret=Q_HANDLED();
   switch (e->sig)
      {
      case Q_ENTRY_SIG:
         {   
            me->done=ModemSendCommand("AT+CSDH=1\r\n");
            me->tick_100ms_counter=0;
            me->counter=0;
         }
         return ret; 
      case TIC_100ms_SIG:
         {
            if ((ret=TickHandler(me))==Q_HANDLED()&&me->done==0)
               {
               me->done=ModemSendCommand("AT+CSDH=1\r\n");
               }
         }
         return ret;
      case MODEM_OK_SIG: return OkHandler(me); 
      case MODEM_ERROR_SIG: return ErrorHandler(me,ANSWER_ERROR);
      case MODEM_SIM_PIN_SIG:
      case MODEM_SIM_PUK_SIG:
      case MODEM_PH_SIM_PIN_SIG:
      case MODEM_PH_SIM_PUK_SIG:
      case MODEM_SIM_PIN2_SIG:
      case MODEM_SIM_PUK2_SIG: return ErrorHandler(me,ANSWER_SIM_LOCK);
      case MODEM_SIM_NOT_READY_SIG:
      case MODEM_SIM_NOT_INSERTED_SIG: return ErrorHandler(me,ANSWER_SIM_ERROR);
      case Q_EXIT_SIG: return Q_HANDLED();
      }
   return Q_IGNORED();
   }
	 
	 
	 QState ModemSM_set_te_character(SIM900 *me,QEvent const *e) 
   {
   QState ret=Q_HANDLED();
   switch (e->sig)
      {
      case Q_ENTRY_SIG:
         {   
            me->done=ModemSendCommand("AT+CSCS=\"IRA\"\r\n");
            me->tick_100ms_counter=0;
            me->counter=0;
         }
         return ret; 
      case TIC_100ms_SIG:
         {
            if ((ret=TickHandler(me))==Q_HANDLED()&&me->done==0)
               {
                me->done=ModemSendCommand("AT+CSCS=\"IRA\"\r\n");
               }
         }
         return ret;
      case MODEM_OK_SIG: return OkHandler(me); 
      case MODEM_ERROR_SIG: return ErrorHandler(me,ANSWER_ERROR);
      case MODEM_SIM_PIN_SIG:
      case MODEM_SIM_PUK_SIG:
      case MODEM_PH_SIM_PIN_SIG:
      case MODEM_PH_SIM_PUK_SIG:
      case MODEM_SIM_PIN2_SIG:
      case MODEM_SIM_PUK2_SIG: return ErrorHandler(me,ANSWER_SIM_LOCK);
      case MODEM_SIM_NOT_READY_SIG:
      case MODEM_SIM_NOT_INSERTED_SIG: return ErrorHandler(me,ANSWER_SIM_ERROR);
      case Q_EXIT_SIG: return Q_HANDLED();
      }
   return Q_IGNORED();
   }
	 
	  QState ModemSM_set_message_storage(SIM900 *me,QEvent const *e) 
   {
   QState ret=Q_HANDLED();
   switch (e->sig)
      {
      case Q_ENTRY_SIG:
         {   
             me->done=ModemSendCommand("AT+CPMS=\"SM\",\"SM\",\"SM\"\r\n");
            me->tick_100ms_counter=0;
            me->counter=0;
         }
         return ret; 
      case TIC_100ms_SIG:
         {
            if ((ret=TickHandler(me))==Q_HANDLED()&&me->done==0)
               {
                me->done=ModemSendCommand("AT+CPMS=\"SM\",\"SM\",\"SM\"\r\n");
               }
         }
         return ret;
      case MODEM_OK_SIG: return OkHandler(me); 
      case MODEM_ERROR_SIG: return ErrorHandler(me,ANSWER_ERROR);
     case MODEM_SIM_PIN_SIG:
      case MODEM_SIM_PUK_SIG:
      case MODEM_PH_SIM_PIN_SIG:
      case MODEM_PH_SIM_PUK_SIG:
      case MODEM_SIM_PIN2_SIG:
      case MODEM_SIM_PUK2_SIG: return ErrorHandler(me,ANSWER_SIM_LOCK);
      case MODEM_SIM_NOT_READY_SIG:
      case MODEM_SIM_NOT_INSERTED_SIG: return ErrorHandler(me,ANSWER_SIM_ERROR);
      case Q_EXIT_SIG: return Q_HANDLED();
      }
   return Q_IGNORED();
   }
	 
	
	 
	 
	 
	  QState ModemSM_aon_on(SIM900 *me,QEvent const *e) 
   {
   QState ret=Q_HANDLED();
   switch (e->sig)
      {
      case Q_ENTRY_SIG:
         {   
            me->done=ModemSendCommand("AT+CLIP=1\r\n");
            me->tick_100ms_counter=0;
            me->counter=0;
         }
         return ret; 
      case TIC_100ms_SIG:
         {
            if ((ret=TickHandler(me))==Q_HANDLED()&&me->done==0)
               {
                me->done=ModemSendCommand("AT+CLIP=1\r\n");
               }
         }
         return ret;
      case MODEM_OK_SIG: return OkHandler(me); 
      case MODEM_ERROR_SIG: return ErrorHandler(me,ANSWER_ERROR);
      case MODEM_SIM_PIN_SIG:
      case MODEM_SIM_PUK_SIG:
      case MODEM_PH_SIM_PIN_SIG:
      case MODEM_PH_SIM_PUK_SIG:
      case MODEM_SIM_PIN2_SIG:
      case MODEM_SIM_PUK2_SIG: return ErrorHandler(me,ANSWER_SIM_LOCK);
      case MODEM_SIM_NOT_READY_SIG:
      case MODEM_SIM_NOT_INSERTED_SIG: return ErrorHandler(me,ANSWER_SIM_ERROR);
      case Q_EXIT_SIG: return Q_HANDLED();
      }
   return Q_IGNORED();
   }
	 
	 

	
	 
	 

QState ModemSM_gsm_reg(SIM900 *me,QEvent const *e) 
   {
   static uint8_t reg00_counter,reg02_counter,reg03_counter,reg04_counter;
   QState ret=Q_HANDLED();
   switch (e->sig)
      {
      case Q_ENTRY_SIG:
         { 
            reg00_counter=reg02_counter=reg03_counter=reg04_counter=0;
            me->tick_100ms_counter=0;
            me->counter=0;
            me->flag.roaming=0;
            me->flag.next_ok=0;
         }
         return ret;
      case TIC_100ms_SIG:
         {
            ret= TickHandler(me); 
            if ((ret==Q_HANDLED())&&(++me->counter==10))
               {
               me->counter=0;
               ModemSendCommand("AT+CREG?\r\n");
               }
         }
         return ret;
      case MODEM_CREG_NOT_REGISTERED_NO_OPERATOR_SEARCHING_SIG://CREG00
         {
					 GsmState=gsm_registration;
            if (++reg00_counter==5)//2x5=10 sec
               {
               ret= ErrorHandler(me,ANSWER_ERROR);
               }
         }
         return ret;
      case MODEM_CREG_REGISTERED_HOME_NETWORK_SIG://CREG01
         {
           GsmState=gsm_registered_in_home;
            me->flag.next_ok=1;
         }
         return ret ;
      case MODEM_CREG_NOT_REGISTERED_BUT_OPERATOR_SEARCHING_SIG://CREG02
         {
             GsmState=gsm_registration;
            if (++reg02_counter==30)//2x30=60 sec
               {
               ret= ErrorHandler(me,ANSWER_ERROR);
               }
         }
         return ret ;
      case MODEM_CREG_REGISTRATION_DENIED_SIG://CREG03
         {
             GsmState=gsm_registration;
            if (++reg03_counter==5)//2x5=10 sec
               {
               ret= ErrorHandler(me,ANSWER_ERROR);
               }
         }
         return ret ;
      case MODEM_CREG_UNKNOWN_ANSWER_SIG://CREG04
         {
             GsmState=gsm_registration;
            if (++reg04_counter==3)//3x2=6 sec
               {
               ret= ErrorHandler(me,ANSWER_ERROR);
               }
         }
         return ret;
      case MODEM_CREG_REGISTERED_ROAMING_SIG://CREG05
         {
            GsmState=gsm_registered_in_roaming;
            me->flag.roaming=1;
            me->flag.next_ok=1;
         }
         return ret ;
      case MODEM_OK_SIG:
         {
            if (me->flag.next_ok==1)ret=OkHandler(me);
         }
         return ret;
      case MODEM_ERROR_SIG: return ErrorHandler(me,ANSWER_ERROR);
      case MODEM_SIM_NOT_READY_SIG:
      case MODEM_SIM_NOT_INSERTED_SIG: return ErrorHandler(me,ANSWER_SIM_ERROR);
      case Q_EXIT_SIG:  return Q_HANDLED();
      }
   return Q_IGNORED();
   } 

QState ModemSM_open_gprs_check_ipstat(SIM900 *me,QEvent const *e) 
   {
   QState ret=Q_HANDLED();
   switch (e->sig)
      {
      case Q_ENTRY_SIG:
         {
            me->tick_100ms_counter=0;
            me->flag.next_ok=0;
            me->flag.exit_ok=0;
            me->done= ModemSendCommand("AT+CIPSTATUS\r\n");
         }
         return ret ;
      case TIC_100ms_SIG:
         {
            if ((ret=TickHandler(me))==Q_HANDLED()&&me->done==0)
               {
               me->done= ModemSendCommand("AT+CIPSTATUS\r\n");
               }
         }
         return ret;
      case MODEM_STATE_TCP_CLOSED_SIG:
         {
            OutDebugSim900("STATE_TCP_CLOSED_SIG");
            answer_evt.answer=ANSWER_OK;
            QACTIVE_POST(AO_Modem, (QEvt*)&answer_evt, me);
            ret= Q_TRAN(&ModemSM_idle); 
         }
         return ret;
      case MODEM_STATE_IP_STATUS_SIG:
         {
            OutDebugSim900("STATE_IP_STATUS_SIG");
            answer_evt.answer=ANSWER_OK;
            QACTIVE_POST(AO_Modem, (QEvt*)&answer_evt, me);
            ret= Q_TRAN(&ModemSM_idle); 
         }
         return ret;
      case MODEM_STATE_IP_INITIAL_SIG:
         {
            OutDebugSim900("STATE_IP_INITIAL_SIG");
            ret=OkHandler(me);
         }
         return ret ;
      case MODEM_STATE_PDP_DEACT_SIG:
         {
            OutDebugSim900("STATE_PDP_DEACT_SIG");
            ret=OkHandler(me);
         }
         return ret ;
      case MODEM_OK_SIG:  return Q_HANDLED();
      case MODEM_ERROR_SIG: return ErrorHandler(me,ANSWER_ERROR);
      case MODEM_SIM_NOT_READY_SIG:
      case MODEM_SIM_NOT_INSERTED_SIG: return ErrorHandler(me,ANSWER_SIM_ERROR);
      case Q_EXIT_SIG: return Q_HANDLED();
      }
   return Q_IGNORED();
   }


QState ModemSM_waiting_gprs_ready(SIM900 *me,QEvent const *e) 
   {
   QState ret=Q_HANDLED();
   switch (e->sig)
      {
      case Q_ENTRY_SIG:
         {
            me->tick_100ms_counter=0;
					  me->counter=0;
            ModemSendCommand("AT+CGATT?\r\n");
         }
         return ret ;
      case TIC_100ms_SIG:
         {
            if ((ret=TickHandler(me))==Q_HANDLED() && ++me->counter==10)
               {
                me->counter=0;
								 ModemSendCommand("AT+CGATT?\r\n");
               }
							 
         }
         return ret;
      case MODEM_GPRS_ATTACHED_SIG:
         {
            OutDebugSim900("GPRS_ATTACHED_SIG");
            ret=OkHandler(me);
         }
         return ret ;
      case MODEM_OK_SIG: return Q_HANDLED() ;
      case MODEM_ERROR_SIG: return ErrorHandler(me,ANSWER_ERROR);
      case MODEM_SIM_NOT_READY_SIG:
      case MODEM_SIM_NOT_INSERTED_SIG: return ErrorHandler(me,ANSWER_SIM_ERROR);
      case Q_EXIT_SIG: return Q_HANDLED() ;
      }
   return Q_IGNORED();
   }
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
